Radecki226/Audio-Stream-KL05Z32/README.md

# Audio-Stream-KL05Z32
Projekt z techniki mikroprocesorowej 2

W pliku tmp2_prezentacja.wav znajduje się zapis audio z prezentacji.

Piotr Radecki 2021
