Radecki226/Audio-Stream-KL05Z32/Piotr_Radecki_sprawozdanie.pdf

## Piotr Radecki

## Raport z projektu:

## „Stream audio przez bluetooth z użyciem modułu HC-05 i płytki FRDM-KL05Z”

### 1. Opis projektu

Celem projektu było stworzenie układu transmitującego dzwięk z mikrofonu elektretowego na komputer i odtwarzanie tego dzwięku „na żywo”- czyli w praktyce z niewielkim opóźnieniem.

Projekt składa się z trzech znaczących komponentów:

- Wzmacniacz analogowy
- Płytka FRDM-KL05 z modułem HC-05
- Komputer PC

Każdy z komponentów zostanie bardziej szczegółowo omówiony w kolejnych punktach sprawozdania.

### 2. Układ Analogowy

Układ został zaprojektowany przeze mnie. Z uwagi na brak możliwości zmierzenia napięcia na mikrofonie parametry wzmocnienia zostały dobrane metodą prób i błędów. Układ składa się ze wzmacniacza, wtórnika emiterowego i filtra dolnoprzepustowego RC. Głównym założeniem było uzyskanie napięcia stałego na wyjściu wtórnika rzędu 1.5V, co stanowi około połowę napięcia referencyjnego przetwornika AC(2.91V) w mikrokontrolerze. Uzyskane napięcie stałe na wyjściu to około 1.7-1.8V co stanowi zadowalający efekt. Użyte tranzystory bipolarne to modele BC546B. Częstotliwość 3dB filtra to 8kHz. Dzięki temu próbkowanie z częstotliwością 16kHz nie powinno spowodować znaczącego aliasingu. Mikrofon modelowany jest źródłem napięcia AC i kondensatorem. Układ zasilany jest bateryjnie z 12V. Poniżej schemat układu analogowego(z uwagi na dostępne komponenty w mojej dystrybucji programu spice, na schemacie przedstawione są tranzystory BC547B- model o podobnej charakterystyce):

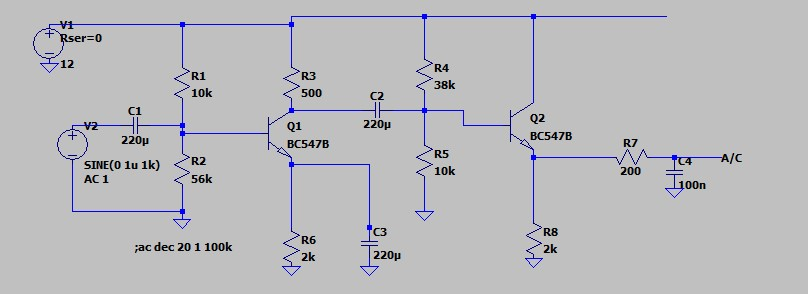
[picture p1: figure]

fig. 1

Wzmocnienie układu w funkcji częstotliwości:

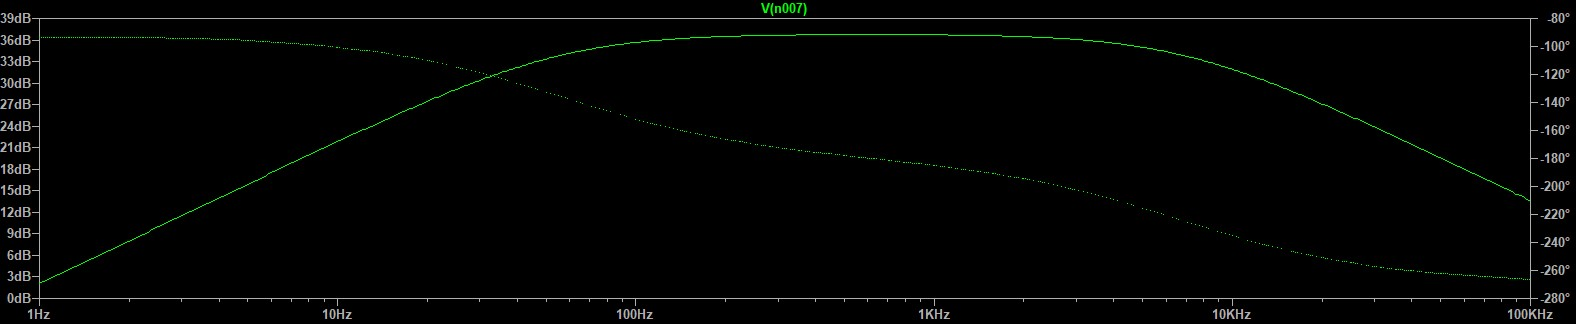
[picture p2: figure]

fig.2

Jak widać na powyższym wykresie wzmacniacz ma przyzwoitą charakterystyką w paśmie akustycznym.

### 3. Płytka FRDM-KL05Z z modułem HC-05

Projekt obejmuje dwa projekty napisane na płytkę:

- Programator
- Program własciwy przerzucający dane

Poza modułem HC-05 używany jest jeszcze wyświetlacz LCD z expanderem i2c, z którego korzystano na zajęciach laboratoryjnych.

Uwaga! To sprawozdanie odnosi się do posiadanej przeze mnie płytki z modułem HC-05. W tej konkretnej dystrybucji znajduje się przycisk do programowania a także wejście Tx należy połączyć z wyjściem Tx płytki FRDM i analogicznie Rx należy połączyć z Rx. Te parametry mogą się różnić dla innych płytek!

### 3.1 Moduł HC-05

Moduł korzysta z komunikacji uart. Możliwe jest używanie go w dwóch trybach:

- Tryb komend
- Tryb komunikacji

W trybie komend używana jest komunikacja z baud rate 38400. W tym trybie przesyłane są komunikaty AT programujące pamięć nieulotną modułu. Możliwe jest ustawienie między innymi takich parametrów jak nazwa, prędkość transmisji, tryb master/slave, hasło. Każdy z komunikatów to string zaterminowany „\r\n”. Lista komend:

HC-05 Bluetooth AT Command List | Microcontroller Tutorials (teachmemicro.com)

W trybie komunikacji używany jest baud rate ustawiony w trybie komend(domyślnie 9600). Wysyłane są dowolne strumienie bitów w protokole uart. Moduł z punktu widzenia mikrokontrolera to urządzenie połączone za pomocą uart, które nadaje i odbiera dane.

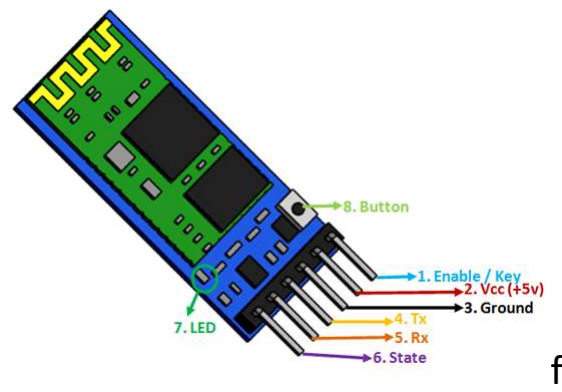
[picture p3: figure]

### 3.2 Programator

Programator znajduje się w folderze poniżej:

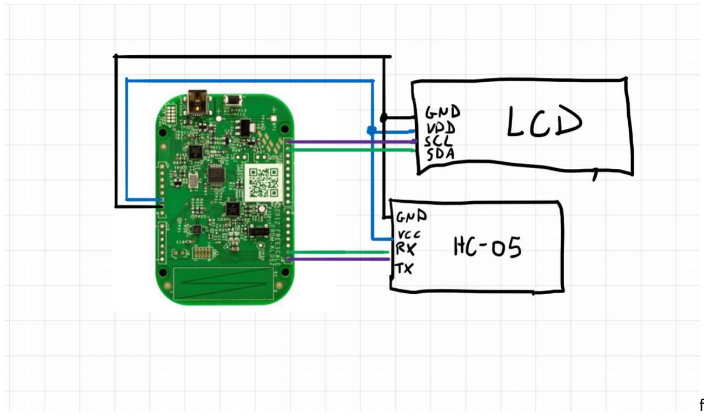
[picture p4: figure]

Podczas włączania zasilania modułu HC
komend! Aby wyjść z tego trybu należy zresetować moduł.

Po wgraniu programu na płytkę zostaną ustawione parametry modułu HC ustawić kolejno: uart(230400,0,0
przysłane potwierdzenia i wartość ustawionych parametrów. Kolejne etapy będą wyświetlane na wyświetlaczu LCD.
bit stopu, brak kontroli parzystości.

Najważniejsze funkcje:

- uart_receive()- odbiera daną z uart gdy będzie gotowa, czyści ekran LCD i wy jako stringa na ekranie.
- uart_hc_05_ms(char* string)
odebranie odpowiedzi i wyświetleniu odpowiedzi na ekranie
- UART_Init(uint32_t baud_rate)

fig. 3- moduł HC-05

programmer w repozytorium. Schemat połączeń

modułu HC-05 należy trzymać wciśnięty przycisk aby przejść do trybu

-05. Program powinien
), nazwę urządzenia(TMP2) i hasło(9999). Ponadto powinny zostać i otrzymane odpowiedzi
Format ustawionego uart oznacza: baud rate=230400, jeden

odbiera daną z uart gdy będzie gotowa, czyści ekran LCD i wy

- jest odpowiedzialna za wysłanie pojedynczego komunikatu,
- pozwala ustawić żądany baud rate i aktywowa

znajduje się

fig. 4

isk aby przejść do trybu

### 05. Program powinien

i otrzymane odpowiedzi
baud rate=230400, jeden

świetla daną

ć moduł uart.

### 3.3 Program główny

Program główny znajduje się w zakładce poniżej:

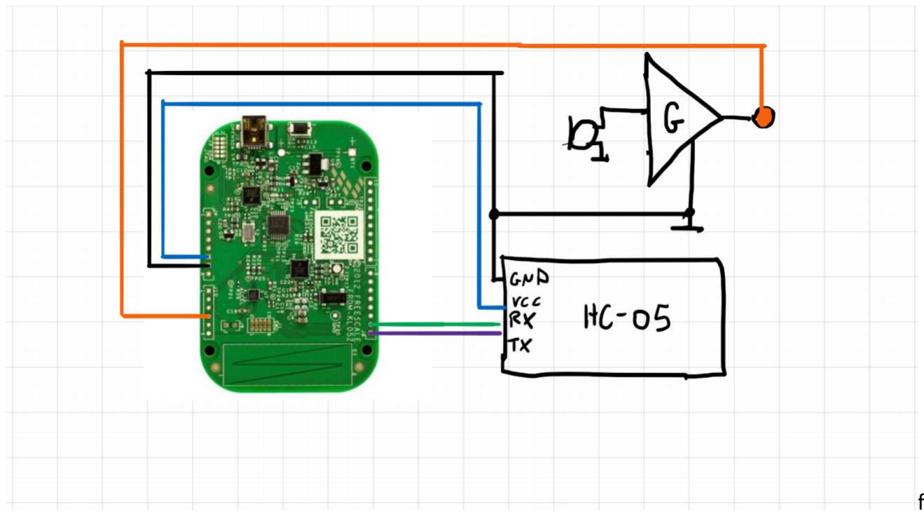
[picture p5: figure]

Program jest taktowany licznikiem PIT. 16 tysięcy razy na sekundę PIT przysyła przerwanie. Wówczas ostatnia dana odebrana z przerwania
przesuwana o 4 miejsca w prawo(w celu zrzutowania danej 12
przez UART z baud rate 230400.
pętlą główną. W praktyce układ stanowi zatem układ pr
filtr antyaliasingowy na wyjściu wzmacniacza
próbkowania możliwe powinno być uzyskanie przyzwoitej jak

Ponownie korzysta się z funkcji UART_Init () pozwalającej ustawić baud rate. Program korzysta z 12 kanału przetwornika A/C.

### 4. Komputer PC z systemem windows i modułuem bluetooth pełniący rolę odbiornika

Aplikacja zna

### 4.1 Konfiguracja

Aby odpowiednio odbierać dane na komputerze z systemem windows należy najpierw odpowiednio skonfigurować porty w systemie.

Aby to zrobić należy:

stream w repozytorium. Schemat połączeń znajduje się

przetwornika A/C jest zapisywana do zmiennej wynik -bitowej na daną 8
Zmienna pit_ok odpowiada za handshake pomiędzy przerwan óbkujący z częstotliwością 16kHz (f3dB = 8kHz) i odpowiednio dobraną częstotliwość ości dzwięku.

t połączeń znajduje się

fig. 5

,
-bitową) i wysyłana
iem a
. Z uwagi na

- Użyć programatora w celu ustawienia odpowiednich parametrów modułu hc-05
- Podłączyć moduł do zasilania
- wejść w Bluetooth & other devices > Add Bluetooth or other device > Bluetooth a następnie wybrać urządzenie TMP2 i wpisać PIN: 9999, urządzenie zostanie sparowane.

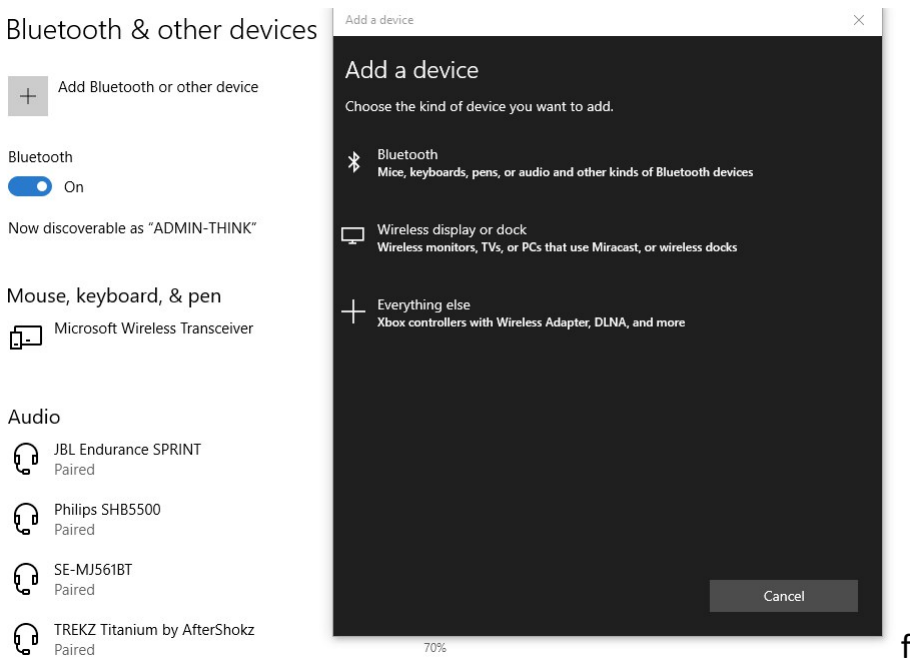
[picture p6: figure]

fig. 6

- Następnie należy wejść w zakładkę More Bluetooth options

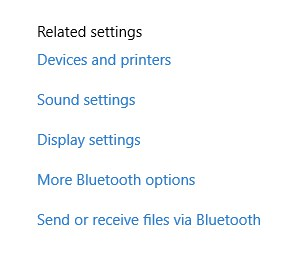
[picture p7: figure]

fig. 7

- Po wyświetleniu się menu należy wejść w zakładkę COM ports, wybrać opcję outgoing a następnie wybrać z rozwijanej listy urządzenie TMP2 i Service: SPP Dev. Po nacisnięciu „ok” urządzenie zostanie przypisane do odpowiedniego portu(w moim przypadku jest to COM5).

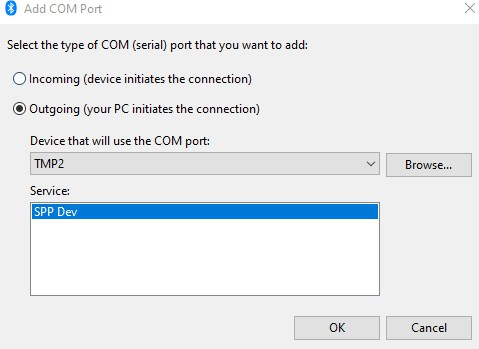
[picture p8: figure]

fig. 8

### 4.2 Odbiornik

Odbiornik został napisany w języku python. Jego zadaniem jest odczyt danych z portu szeregowego i transmisja tych danych na głośnik. Cały tor transmisyjny powoduje bardzo niewielkie opóźnienia, w związku z czym dzwięk jest transmitowany na żywo.

Oprócz transmisji, program realizuje też zapis dzwięku. Podczas wykonywania programu dane przechowywane są w dynamicznej tablicy. Po zakończeniu programu użytkownik ma możliwość zapisu sesji w pliku o formacie .wav.

Odbiornik dostarcza prosty interfejs graficzny użytkownika. Po włączeniu programu i inicjalizacji portu użytkownik ma dostęp do okienka z trzema opcjami: start, stop, quit.

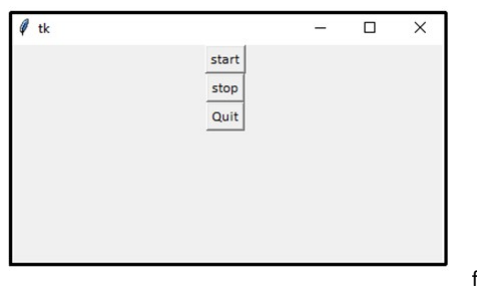
[picture p9: figure]

fig. 9

- Opcja start:

Po wystartowaniu program zaczyna transmitować i zapisywać dzwięk, trwa to aż do momentu naciśnięcia przycisku stop.

- Opcja stop:

Program czyta dane z bufora jednak nie zapisuje ich ani nie transmituje. Czytanie ma na celu jedynie opróżnienie bufora.

- Opcja quit:

Po wybraniu tej opcji zamykany jest port a użytkownikowi wyświetla się przebieg czasowy dzwięku. Po zamknięciu wykresu użytkownik jest pytany o chęć zapisu dzwięku do pliku. W przypadku wpisania ścieżki do pliku .wav zostanie utworzony nowy plik lub nadpisany stary o tej samej nazwie. W przpadku wybrania opcji cancel dane nie zostaną zapisane.
