Radecki226/Audio-Stream-KL05Z32/stream/pit.c

#include "MKL05Z4.h"
#include	"pit.h"



void PIT_Init(void)
{
	uint32_t tsv;
	SIM->SCGC6 |= SIM_SCGC6_PIT_MASK;			// Włączenie sygnału zegara do modułu PIT
	PIT->MCR &= ~PIT_MCR_MDIS_MASK;				// Włączenie modułu PIT
	tsv=BUS_CLOCK/16000;									// Czestotliwosc przerwan 16kHz
	PIT->CHANNEL[0].LDVAL = PIT_LDVAL_TSV(tsv);		// Załadowanie wartości startowej
	PIT->CHANNEL[0].TCTRL = PIT_TCTRL_TEN_MASK | PIT_TCTRL_TIE_MASK;		// Odblokowanie przerwania i wystartowanie licznika
	NVIC_SetPriority(PIT_IRQn,0);
	NVIC_ClearPendingIRQ(PIT_IRQn);
	NVIC_EnableIRQ(PIT_IRQn);	
}
